westial/karatemeter/doc/Quickstart.pdf

# KARATEMETER Quickstart

1. Install the Controller Box and the Sensor for playing against a target like makiwara (巻藁) or attached to your body for training.

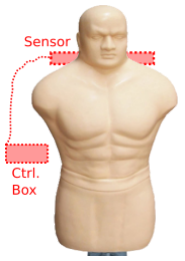
[picture p17: figure]
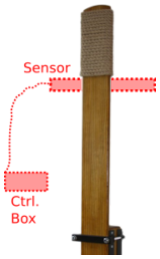
[picture p18: figure]
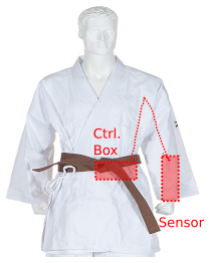
[picture p19: figure]
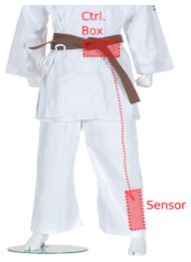
[picture p20: figure]

2. Configure the settings first because every change in settings requires a RESTART..

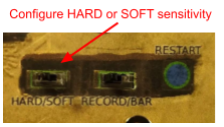
[picture p21: figure]

3. Turn on the Controller Box.

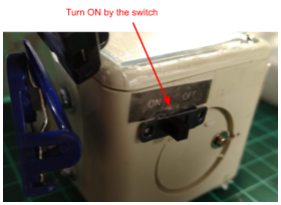
[picture p22: figure]

## 4. Enjoy!

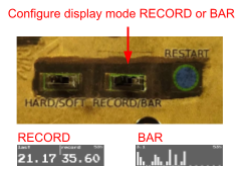
[picture p23: figure]

GNU General Public License. By westial. https://github.com/westial/karatemeter
