westial/karatemeter/doc/LithiumIonBatterySafety.pdf

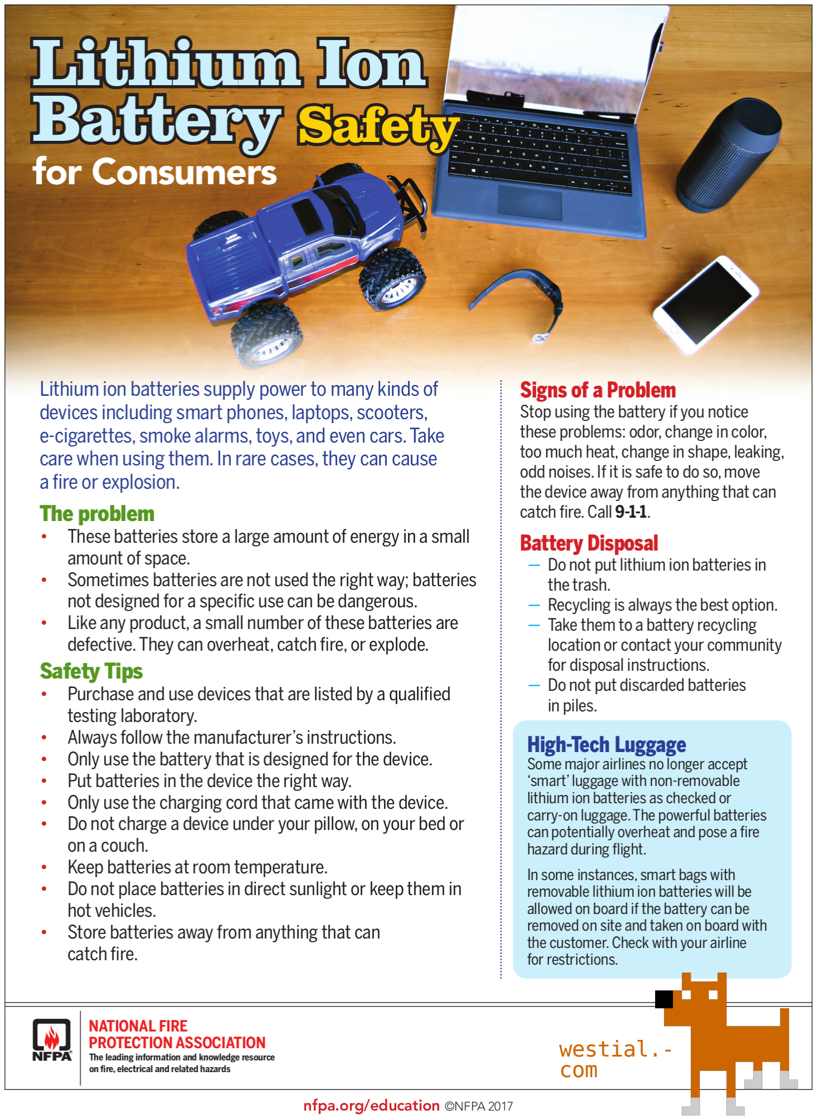
[picture p24: page 1]

westial. com
