westial/karatemeter/doc/img/batterycharged.jpg

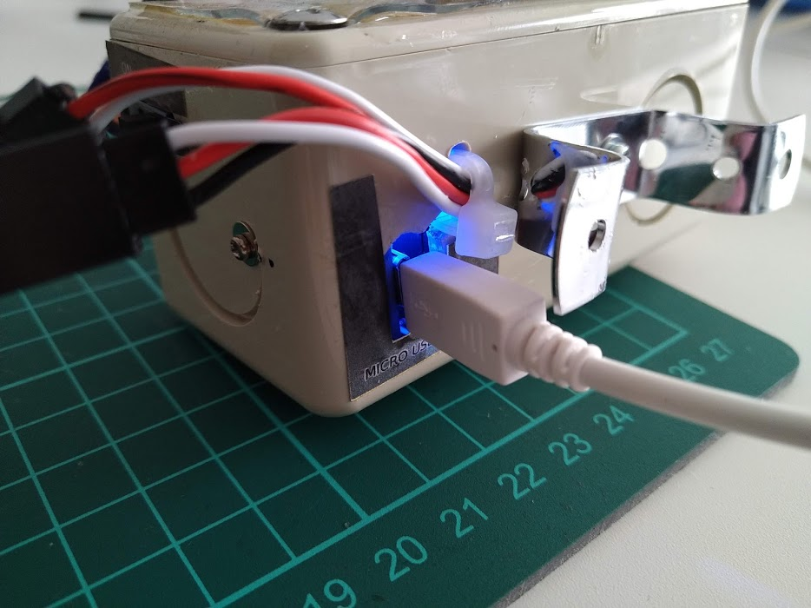
doc/img/batterycharged.jpg
