westial/karatemeter/doc/img/batterycharging.jpg

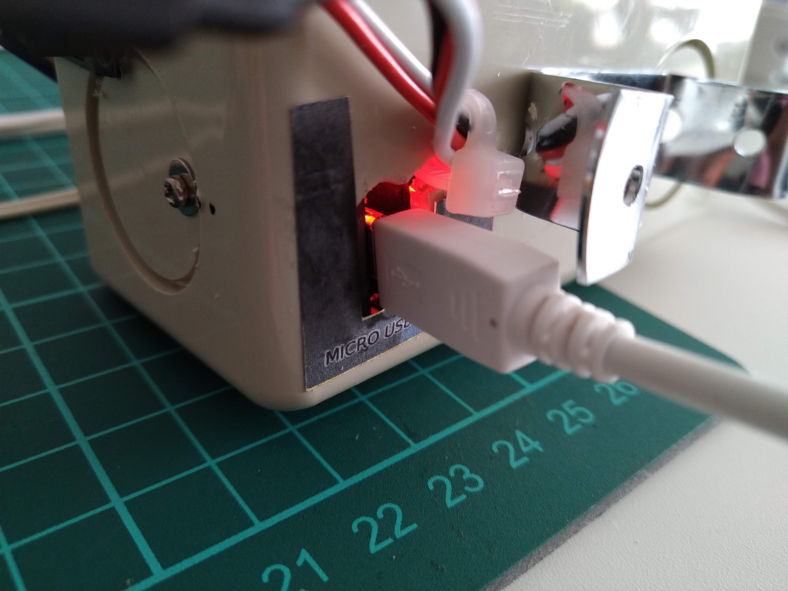
doc/img/batterycharging.jpg
