westial/karatemeter/(commit log)

2021-05-13 First working version
    [karatemeter.kicad_pcb, karatemeter.sch]
2021-05-13 A little oversight in the load sharing circuit
    [karatemeter.sch]
2021-05-14 Replaced 3 axes impact for mono axis impact for simplicity
    [3AxesImpactTest.cpp, MeasureAndDisplayByModeUseCaseTest.cpp, MonoImpactTest.cpp]
2021-05-14 Calculate pythagorean acceleration in Arduino sketch
